pandemiaplan/IncuNest/Hardware/Electronics/FullLEDStrip/in3ator_LEDStrip2.html

Reporting Options

# File in Newer Format

Date | : | 14/08/2024
Time | : | 11:28:09
Project name | : | C:\Users\Administrator\Documents\in3ator_altium\Prototypes\FullLEDStrip2\in3ator_LEDStrip2.PrjPcb
Schematic documents | : | in3ator_LEDStrip2.SchDoc

Version | Warning
22.3.0 | Custom diff pair suffixes are not supported in this version.

These files were generated in a later version of Altium Designer. Be aware that some data may have been added through functionality not available in your current version and will therefore not be available to you.
