pandemiaplan/IncuNest/Hardware/Electronics/Ambient_sensor/PCB_Project/Project Outputs for in3ator_RoomSensor/BOM/Bill of Materials-in3ator_RoomSensor.xlsx

Comment | Designator | Quantity | LCSC_PN
100nF 0402 X7R 50V | C1, C5 | 2 | C77020
1uF 0402 X5R 25V | C7, C42 | 2 | C77009
ESDALC6V1P6 | D1 | 1 | C1976562
STS35-DIS | U1, U2 | 2 | C5439927
SPX3819M5-L-3-3/TR | U7 | 1 | C9055
XKB U262-16XN-4BVC11 | USB1 | 1 | C319148
