pandemiaplan/IncuNest/Hardware/Electronics/Ambient_sensor/PCB_Project/Project Outputs for in3ator_RoomSensor/v1/BOM/Bill of Materials-in3ator_RoomSensor.xlsx

Comment | Designator | Footprint | JLCPCB Part #（optional）
100nF 0402 X7R 50V | C5 | 1 | C77020
1uF 0402 X5R 25V | C7, C42 | 2 | C77009
ESDA5V3SC5 | D6 | 1 | C2827708
Sensirion SHTC3 | U5 | 1 | C194656
SPX3819M5-L-3-3/TR | U7 | 1 | C9055
XKB U262-16XN-4BVC11 | USB1 | 1 | C319148
