pandemiaplan/IncuNest/Hardware/Electronics/Motherboard/Project Outputs for in3ator/V15.1/JLCPCB/8.E/BOM/Bill of Materials-in3ator(Main).xlsx

Comment | Designator | Quantity | LCSC_PN
CUI CMT-1285C-035 | BUZ1 | 1 | C252915
100nF 0603 X7R 100V | C1, C5, C7, C8, C11, C18, C19, C20, C21, C22, C23, C24, C26, C29, C31 | 15 | C14663
10uF 0603 X5R 25V | C2, C6, C15, C16, C27, C28, C30, C32 | 8 | C479655
1nF 0603 NP0 50V 1% | C3, C34 | 2 | C309468
1uF 0603 X5R 16V | C4, C17, C25, C36 | 4 | C106215
18pF 0603 NPO 5% 50V | C12 | 1 | C107040
330uF ±20% 6V3 6.3mm 7.7mm | C14 | 1 | C88664
220uF 30V 8x10mm 5000hrs | C35 | 1 | C134820
1.5nF 0603 NP0 50V 1% | C37 | 1 | C309468
SMBJ15CA | D1 | 1 | C499834
ESDA6V1-5SC6 | D2, D3, D4, D5, D6, D7 | 6 | C6650
SS14_C83852 | D8 | 1 | C83852
BLM18HG601SN1D | FB1 | 1 | C85830
Degson 2EDGK-5.08-02P-14-00AH | J1, J4 | 2 | C8445
JST B2B-XH-A | J2 | 1 | C158012
TE Connectivity 1734366-3 | J6, J13 | 2 | C32896
B2B-PH-K-S(LF)(SN) | J7 | 1 | C131337
WJ15EDGVC-3.81-2P | J8 | 1 | C8396
KF2EDGVC-5.08-4P | J9 | 1 | C581330
220uH | L1 | 1 | C339959
180uH | L2 | 1 | C329730
150060GS55040 | LED1 | 1 | C84266
BC817-16 | Q1, Q7 | 2 | C126908
Infineon IRLB8314PBF | Q2 | 1 | C492741
IRLML6244TRPBF | Q3, Q4, Q5, Q10, Q11 | 5 | C143946
IPD90P03P404ATMA1 | Q6 | 1 | C148439
NTR1P02LT1G | Q8 | 1 | C2593
FQD2N60CTM | Q9 | 1 | C5386
0.002R 1206 0.5W 1% | R1 | 1 | C154631
10K 0603 0.1W 1% | R2, R11, R14, R19, R21, R23, R25, R27, R28, R29, R30, R37, R38, R39, R42, R45, R50, R51, R52, R55, R59, R60, R62, R67 | 24 | C319939
1K 0603 0.1W 1% | R4, R6, R10, R12, R13, R16, R17, R18, R20, R24, R31, R43, R44, R46, R47, R49, R57 | 17 | C21190
0.1R 0603 0.1W 1% | R5, R26 | 2 | C713431
0R 0603 0.1W 1% | R15, R32, R33, R34, R35, R36, R48, R53, R58, R72 | 10 | C21189
0.02R 1206 0.5W 1% | R22 | 1 | C127690
5k6 0603 0.1W 1% | R56 | 1 | C114627
1R 0603 0.1W 1% | R64, R68, R69 | 3 | C22936
300R 0603 0.1W 1% | R65 | 1 | C114617
180R 0603 0.1W 1% | R66 | 1 | C22828
820R 0603 0.1W 1% | R70 | 1 | C114638
Bourns PEC11R-4215F-S0024 | SW1 | 1 | C470742
Espressif Systems ESP32-WROOM-32D | U1 | 1 | C701343
Simcom SIM800C | U2 | 1 | C69119
Microchip PAC1933T-I/JQ | U4 | 1 | C623959
Texas Instruments INA180A3IDBVR | U5, U12, U15 | 3 | C122882
STMicroelectronics L78M05CDT-TR | U6 | 1 | C173987
Sensirion SHTC3 | U7 | 1 | C194656
LD1117S33CTR | U9, U10 | 2 | C35879
Micrel MIC29302WU | U11 | 1 | C11149
SPX3819M5-L-3-3/TR | U13 | 1 | C9055
NE555DR | U14 | 1 | C596355
MC34063ADR2G | U16 | 1 | C32078
XKB U262-16XN-4BVC11 | USB1, USB2 | 2 | C319148
