pandemiaplan/IncuNest/Hardware/Electronics/Motherboard/Project Outputs for in3ator/V15.1/JLCPCB/9.B/BOM/Bill of Materials-in3ator(Main).xlsx

Comment | Designator | Footprint | JLCPCB Part #
CUI CMT-1285C-035 | BUZ1 | 1 | C252915
100nF 0603 X7R 100V | C1, C5, C5_1, C6, C8, C11, C14, C18, C19, C20, C21, C21_1, C30, C34, C38, C41 | 16 | C14663
10uF 0603 X5R 25V | C2, C2_1, C23, C24, C25, C26, C28, C29, C31, C32, C35, C36, C37, C39, C40 | 15 | C479655
1uF 0603 X5R 16V | C3, C3_1, C4, C7, C7_1, C17, C22, C22_1 | 8 | C106215
18pF 0603 NPO 5% 50V | C12 | 1 | C107040
SMBJ15CA | D1 | 1 | C499834
ESDA6V1-5SC6 | D2 | 1 | C6650
ESDA5V3SC5 | D3, D3_1, D4, D5, D6, D6_1, D7 | 7 | C111204
BAT54S-7-F | D8, D9, D9_1 | 3 | C83574
Degson 2EDGK-5.08-02P-14-00AH | J1, J4 | 2 | C8445
JST B2B-XH-A | J2 | 1 | C158012
TE Connectivity 1734366-3 | J6, J13 | 2 | C32896
B2B-PH-K-S(LF)(SN) | J7, J7_1 | 2 | C131337
WJ15EDGVC-3.81-2P | J8 | 1 | C8396
KF2EDGVC-5.08-4P | J9 | 1 | C581330
HTSW-102-07-G-D | J10, J10_1, J11, J11_1 | 4 | C402780
1217AS-H-3R3N=P3 | L2, L3 | 2 | C160949
150060GS55040 | LED1, LED1_1 | 2 | C84266
BC817-16 | Q1, Q7, Q9 | 3 | C126908
IRLR7843TRPBF | Q2 | 1 | C21988
IRLML6244TRPBF | Q3, Q4, Q11, Q11_1 | 4 | C143946
IPD90P03P404ATMA1 | Q5, Q6 | 2 | C148439
0.002R 1206 0.5W 1% | R1 | 1 | C601094
10K 0603 0.1W 1% | R2, R11, R14, R19, R21, R23, R25, R26, R26_1, R27, R28, R29, R30, R37, R38, R39, R42, R46, R51, R52, R77 | 21 | C319939
1K 0603 0.1W 1% | R4, R6, R10, R12, R13, R16, R17, R18, R20, R31, R43, R44, R47, R47_1, R48, R48_1, R49, R54, R54_1, R64, R64_1 | 21 | C21190
0.1R 0603 0.1W 1% | R5 | 1 | C713431
0R 0603 0.1W 1% | R15, R32, R33, R34, R35, R36, R53, R60, R60_1, R66, R66_1 | 11 | C21189
0.02R 1206 0.5W 1% | R22, R24, R24_1 | 3 | C127690
73K2 0603 0.1W 1% | R45 | 1 | C14890
56K2 0603 0.1W 1% | R50 | 1 | C14890
Bourns PEC11R-4215F-S0024 | SW1 | 1 | C470742
Espressif Systems ESP32-WROOM-32D | U1 | 1 | C701343
Simcom SIM800C | U2 | 1 | C69119
SIM-S-IO3-MFF2-2 | U3 | 1 | C5122390
INA3221AIRGVR | U4 | 1 | C181255
Sensirion SHTC3 | U5, U5_1 | 2 | C194656
TPS563231DRLR | U6, U11 | 2 | C779412
SPX3819M5-L-3-3/TR | U7, U7_1, U12, U12_1 | 4 | C9055
LD1117S33CTR | U10 | 1 | C35879
STM32G030F6P6TR | U13, U13_1 | 2 | C529330
Texas Instruments INA180A3IDBVR | U14, U14_1 | 2 | C122882
XKB U262-16XN-4BVC11 | USB1, USB1_1, USB2, USB2_1 | 4 | C319148
