pandemiaplan/IncuNest/Hardware/Electronics/Motherboard/Project Outputs for in3ator/V15.1/JLCPCB/Humidifier/BOM/Bill of Materials-in3ator(Main).xlsx

Comment | Designator | Footprint | JLCPCB Part #（optional）
CUI CMT-1285C-035 | BUZ1 | 1 | C252915
100nF 0402 X7R 50V | C1, C5, C6, C8, C11, C14, C15, C18, C19, C20, C21, C30, C34, C38, C41, C44, C48, C50 | 18 | C77020
10uF 0402 X5R 10V | C2, C23, C24, C25, C26, C28, C29, C35, C36, C37, C45, C46, C47, C49 | 14 | C77000
1uF 0402 X5R 25V | C3, C4, C7, C17, C22, C27, C42 | 7 | C77009
18pF 0402 X5R 50V | C12, C43 | 2 | C33149
180F 3V8 5mm radial | C16 | 1
10uF 0603 X5R 25V | C31, C32, C39, C40 | 4 | C2230375
SMBJ15CA | D1 | 1 | C78410
ESDA6V1-5SC6 | D2 | 1 | C6650
ESDA5V3SC5 | D3, D6 | 2 | C111204
ESD9B3.3ST5G | D4, D5, D7, D10, D11, D12, D13, D14, D15, D16, D17, D18, D19, D20, D21, D22, D23, D24, D25, D26, D30 | 21 | C96512
MMSZ5231BT1G | D8 | 1 | C66198
BAT54S-7-F | D9 | 1 | C83574
CUS10S30,H3F | D27 | 1 | C146335
Degson 2EDGK-5.08-02P-14-00AH | J1, J4 | 2 | C8445
JST B2B-XH-A | J2 | 1 | C158012
TE Connectivity 1734366-3 | J6, J13 | 2 | C32896
B2B-PH-K-S(LF)(SN) | J7 | 1 | C131337
WJ15EDGVC-3.81-2P | J8 | 1 | C8396
KF2EDGVC-5.08-4P | J9 | 1 | C581330
HTSW-102-07-G-D | J10, J11 | 2 | C402780
B3B-XH-A(LF)(SN) | J12 | 1 | C144394
1217AS-H-3R3N=P3 | L2, L3, L4 | 3 | C514864
150060GS55040 | LED1 | 1 | C84266
BC817-16 | Q1 | 1 | C126908
IRLR7843TRPBF | Q2 | 1 | C21988
IRLML6244TRPBF | Q3, Q4, Q7, Q9, Q11 | 5 | C143946
IPD90P03P404ATMA1 | Q5, Q6 | 2 | C148439
IRLML6402TRPBF | Q8 | 1 | C2593
0.002R 1206 0.5W 1% | R1, R52 | 2 | C601094
10k 0402 0.1% | R2, R3, R7, R8, R9, R11, R14, R19, R21, R23, R25, R26, R27, R28, R29, R30, R31, R37, R38, R39, R40, R41, R46, R57 | 24 | C190095
1k 0402 1% | R4, R6, R10, R12, R13, R16, R17, R18, R20, R43, R44, R47, R48, R49, R54, R64 | 16 | C106235
0.1R 1206 0.5W 1% | R5, R51 | 2 | C601090
0R 0402 1% | R15, R32, R33, R34, R35, R42, R53, R63 | 8 | C60485
0.082R 1206 0.5W 1% | R22 | 1 | C705560
0.02R 1206 0.5W 1% | R24 | 1 | C127690
27R 1206 0.75W 1% | R36 | 1 | C2081644
73k2 0402 1% | R45 | 1 | C185398
51k 0402 0.1% | R50 | 1 | C149896
Bourns PEC11R-4215F-S0024 | SW1 | 1 | C470742
XKB7070-Z | SW2 | 1 | C318863
Espressif Systems ESP32-WROOM-32D | U1 | 1 | C701343
Simcom SIM800C | U2 | 1 | C69119
eSIM MFF2 | U3 | 1 | C5122390
INA3221AIRGVR | U4, U9 | 2 | C181255
Sensirion SHTC3 | U5 | 1 | C194656
TPS563231DRLR | U6, U11 | 2 | C779412
SPX3819M5-L-3-3/TR | U7, U12 | 2 | C9055
2.8 TFT ST7789V | U8 | 1 | C2939938
TPS63001DRCR | U10 | 1
STM32G030F6P6TR | U13 | 1 | C529330
Texas Instruments INA180A3IDBVR | U14 | 1 | C122882
SHT40-AD1B-R2 | U15 | 1
XKB U262-16XN-4BVC11 | USB1, USB2 | 2 | C319148
