pandemiaplan/IncuNest/Hardware/Electronics/FullLEDStrip/Project Outputs for in3ator_LEDStrip2/BOM/Bill of Materials-in3ator_LEDStrip2.xlsx

Comment | Designator | Footprint | JLCPCB Part #（optional）
XL-3014UBC-02 | D1, D2, D3, D4, D5, D6, D7, D8, D9, D10, D11, D12, D13, D14, D15, D16, D17, D18, D19, D20, D21, D22, D23, D24, D25, D26, D27, D28, D29, D30, D31, D32, D33, D34, D35, D36, D37, D38, D39, D40, D41, D42, D43, D44, D45, D46, D47, D48, D49, D50, D51, D52, D53, D54, D55, D56, D57, D58, D59, D60, D61, D62, D63, D64, D65, D66, D67, D68, D69, D70, D71, D72, D73, D74, D75 | 75 | C2843789
39R 1206 0.5W 1% | R1, R2, R3, R4, R5, R6, R7, R8, R9, R10, R11, R12, R13, R14, R15, R16, R17, R18, R19, R20, R21, R22, R23, R24, R25 | 25 | C137295
