pandemiaplan/IncuNest/(list of files, cad)

Other CAD files:
Hardware/Electronics/Motherboard/Step/IncuNest.step
Hardware/Mechanical/IN3_structure_v12 v87.step
