pandemiaplan/IncuNest/Firmware/motherBoard/ESP32S3_OTA_partition_8MB.csv

# Name | Type | SubType | Offset | Size | Flags
nvs | data | nvs | 0x9000 | 0x5000
otadata | data | ota | 0xE000 | 0x2000
app0 | app | ota_0 | 0x10000 | 0x2A0000
app1 | app | ota_1 | 0x2B0000 | 0x2A0000
spiffs | data | spiffs | 0x550000 | 0x200000
