pandemiaplan/IncuNest/Firmware/motherBoard/ESP32_OTA_partition_4MB.csv

# Name | Type | SubType | Offset | Size | Flags
nvs | data | nvs | 0x9000 | 0x4000
otadata | data | ota | 0xd000 | 0x2000
app0 | app | ota_0 | 0x10000 | 0x1F0000
app1 | app | ota_1 | 0x200000 | 0x1F0000
spiffs | data | spiffs | 0x3F0000 | 0x10000
