pandemiaplan/IncuNest/(list of files, drawings)

Other design files:
Hardware/Electronics/Ambient_sensor/PCB/RoomSensor.PcbDoc
Hardware/Electronics/Ambient_sensor/PCB_Project/in3ator_RoomSensor.PrjPcb
Hardware/Electronics/Ambient_sensor/Schematic/Camera.SchDoc
Hardware/Electronics/Ambient_sensor/Schematic/Main.SchDoc
Hardware/Electronics/Ambient_sensor/Schematic/Power_Input.SchDoc
Hardware/Electronics/Ambient_sensor/Schematic/Sensors.SchDoc
Hardware/Electronics/Ambient_sensor/Schematic/uC.SchDoc
Hardware/Electronics/FullLEDStrip/in3ator_LEDStrip2.PcbDoc
Hardware/Electronics/FullLEDStrip/in3ator_LEDStrip2.PcbLib
Hardware/Electronics/FullLEDStrip/in3ator_LEDStrip2.PrjPcb
Hardware/Electronics/FullLEDStrip/in3ator_LEDStrip2.SchDoc
Hardware/Electronics/FullLEDStrip/in3ator_LEDStrip2.SchLib
Hardware/Electronics/Motherboard/IncuNest.PrjPcb
Hardware/Electronics/Motherboard/Project Outputs for in3ator/V15.1/Sources/in3ator.PrjPcb
Hardware/Electronics/Motherboard/Project Outputs for in3ator/V15.1/Sources/Schematic/Actuators.SchDoc
Hardware/Electronics/Motherboard/Project Outputs for in3ator/V15.1/Sources/Schematic/AFE.SchDoc
Hardware/Electronics/Motherboard/Project Outputs for in3ator/V15.1/Sources/Schematic/Battery.SchDoc
Hardware/Electronics/Motherboard/Project Outputs for in3ator/V15.1/Sources/Schematic/Buzzer.SchDoc
Hardware/Electronics/Motherboard/Project Outputs for in3ator/V15.1/Sources/Schematic/GSM.SchDoc
Hardware/Electronics/Motherboard/Project Outputs for in3ator/V15.1/Sources/Schematic/in3ator.SchDoc
Hardware/Electronics/Motherboard/Project Outputs for in3ator/V15.1/Sources/Schematic/Power_Input.SchDoc
Hardware/Electronics/Motherboard/Project Outputs for in3ator/V15.1/Sources/Schematic/Power_management.SchDoc
Hardware/Electronics/Motherboard/Project Outputs for in3ator/V15.1/Sources/Schematic/Sensors.SchDoc
Hardware/Electronics/Motherboard/Project Outputs for in3ator/V15.1/Sources/Schematic/uC.SchDoc
Hardware/Electronics/Motherboard/Schematic/Actuators.SchDoc
Hardware/Electronics/Motherboard/Schematic/AFE.SchDoc
Hardware/Electronics/Motherboard/Schematic/Battery.SchDoc
Hardware/Electronics/Motherboard/Schematic/Buzzer.SchDoc
Hardware/Electronics/Motherboard/Schematic/Display.SchDoc
Hardware/Electronics/Motherboard/Schematic/GSM.SchDoc
Hardware/Electronics/Motherboard/Schematic/Main.SchDoc
Hardware/Electronics/Motherboard/Schematic/Power_Input.SchDoc
Hardware/Electronics/Motherboard/Schematic/Power_management.SchDoc
Hardware/Electronics/Motherboard/Schematic/Sensors.SchDoc
Hardware/Electronics/Motherboard/Schematic/uC.SchDoc
Hardware/Electronics/old/Humidifier/PCB/Humidifier.PcbDoc
Hardware/Electronics/old/Humidifier/PCB_Project/in3ator_Humidifier.PrjPcb
Hardware/Electronics/old/Humidifier/Schematic/Humidifier.SchDoc
