pandemiaplan/IncuNest/Firmware/motherBoard/src/sensors.cpp

/*
  MIT License

  Copyright (c) 2022 Medical Open World, Pablo Sánchez Bergasa

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
*/
#include <Arduino.h>

#include "main.h"

extern TwoWire *wire;
extern MAM_in3ator_Humidifier in3_hum;
extern TFT_eSPI tft;
extern SHTC3 mySHTC3; // Declare an instance of the SHTC3 class
extern SensirionI2cSts3x mySTS35[STS3X_NUM];
extern Adafruit_SHT4x sht4;
extern RotaryEncoder encoder;
extern Beastdevices_INA3221 mainDigitalCurrentSensor;
extern Beastdevices_INA3221 secundaryDigitalCurrentSensor;

extern bool WIFI_EN;
extern long lastDebugUpdate;
extern long loopCounts;
extern int page;
extern double errorTemperature[SENSOR_TEMP_QTY], temperatureCalibrationPoint;
extern double ReferenceTemperatureRange, ReferenceTemperatureLow;
extern double provisionalReferenceTemperatureLow;
extern double fineTuneSkinTemperature, fineTuneAirTemperature;
extern double RawTemperatureLow[SENSOR_TEMP_QTY],
    RawTemperatureRange[SENSOR_TEMP_QTY];
extern double provisionalRawTemperatureLow[SENSOR_TEMP_QTY];
extern int temperature_array_pos; // temperature sensor number turn to measure
extern float diffSkinTemperature,
    diffAirTemperature; // difference between measured temperature and user
                        // input real temperature
extern bool humidifierState, humidifierStateChange;
extern int previousHumidity; // previous sampled humidity
extern float diffHumidity;   // difference between measured humidity and user
                             // input real humidity

extern byte autoCalibrationProcess;

// Sensor check rate (in ms). Both sensors are checked in same interrupt and
// they have different check rates
extern byte encoderRate;
extern byte encoderCount;

extern volatile long lastEncPulse;
extern volatile bool statusEncSwitch;

// WIFI
extern bool WIFI_connection_status;

extern bool roomSensorPresent[ROOM_SENSOR_POSIBILITIES];
extern bool ambientSensorPresent;
extern bool digitalCurrentSensorPresent[2];

// room variables;
extern boolean A_set;
extern boolean B_set;
extern int encoderpinA;                 // pin  encoder A
extern int encoderpinB;                 // pin  encoder B
extern bool encPulsed, encPulsedBefore; // encoder switch status
extern bool updateUIData;
extern volatile int EncMove;     // moved encoder
extern volatile int lastEncMove; // moved last encoder
extern volatile int
    EncMoveOrientation;            // set to -1 to increase values clockwise
extern int last_encoder_move;      // moved encoder
extern long encoder_debounce_time; // in milliseconds, debounce time in encoder
                                   // to filter signal bounces
extern long last_encPulsed;        // last time encoder was pulsed

// Text Graphic position variables
extern int humidityX;
extern int humidityY;
extern int temperatureX;
extern int temperatureY;
extern int ypos;
extern bool print_text;
extern int initialSensorPosition;
extern bool pos_text[8];

extern bool enableSet;
extern float temperaturePercentage, temperatureAtStart;
extern float humidityPercentage, humidityAtStart;
extern int barWidth, barHeight, tempBarPosX, tempBarPosY, humBarPosX,
    humBarPosY;
extern int screenTextColor, screenTextBackgroundColour;

// User Interface display variables
extern bool autoLock; // setting that enables backlight switch OFF after a
                      // given time of no user actions
extern long
    lastbacklightHandler; // last time there was a encoder movement or pulse

extern bool selected;
extern char cstring[128];
extern char *textToWrite;
extern char *words[12];
extern char *helpMessage;
extern byte bar_pos;
extern byte menu_rows;
extern byte length;
extern long lastGraphicSensorsUpdate;
extern long lastSensorsUpdate;
extern bool enableSetProcess;
extern long blinking;
extern bool state_blink;
extern bool blinkSetMessageState;
extern long lastBlinkSetMessage;

extern long lastSuccesfullSensorUpdate[SENSOR_TEMP_QTY];
extern QueueHandle_t sharedSensorQueue;

extern double HeaterPIDOutput;
extern double skinControlPIDInput;
extern double airControlPIDInput;
extern double humidityControlPIDOutput;
extern int humidifierTimeCycle;
extern unsigned long windowStartTime;

extern double Kp[numPID], Ki[numPID], Kd[numPID];
extern PID airControlPID;
extern PID skinControlPID;
extern PID humidityControlPID;

// Sampling frequency
const double FILTER_SAMPLE_FREQUENCY = 1000; // Hz
// Cut-off frequency (-3 dB)
const double FILTER_CUTOFF_FREQUENCY = 10; // Hz
// Normalized cut-off frequency
const double FILTER_NORMALIZED_CUT_OFF_FREQUENCY =
    (2 * FILTER_CUTOFF_FREQUENCY / FILTER_SAMPLE_FREQUENCY);

// Sample timer for filter
Timer<micros> timer = std::round(1e6 / FILTER_SAMPLE_FREQUENCY);
// Sixth-order Butterworth filter
auto filter_0 = butter<6>(FILTER_NORMALIZED_CUT_OFF_FREQUENCY);
auto filter_1 = butter<6>(FILTER_NORMALIZED_CUT_OFF_FREQUENCY);
auto filter_2 = butter<6>(FILTER_NORMALIZED_CUT_OFF_FREQUENCY);

extern in3ator_parameters in3;

long lastCurrentMeasurement, lastVoltageMeasurement;
long lastEncoderUpdate;

void currentMonitor() {
  if (millis() - lastCurrentMeasurement > CURRENT_UPDATE_PERIOD_MS) {
    if (digitalCurrentSensorPresent[MAIN]) {
      in3.system_current = measureMeanConsumption(MAIN, SYSTEM_SHUNT_CHANNEL);
      in3.fan_current = measureMeanConsumption(MAIN, FAN_SHUNT_CHANNEL);
      in3.phototherapy_current =
          measureMeanConsumption(MAIN, PHOTOTHERAPY_SHUNT_CHANNEL);
    }
    if (digitalCurrentSensorPresent[SECUNDARY]) {
      in3.heater_current =
          measureMeanConsumption(SECUNDARY, HEATER_SHUNT_CHANNEL);
      in3.USB_current = measureMeanConsumption(SECUNDARY, USB_SHUNT_CHANNEL);
      in3.BATTERY_current =
          measureMeanConsumption(SECUNDARY, BATTERY_SHUNT_CHANNEL);
    }
    lastCurrentMeasurement = millis();
  }
}

void voltageMonitor() {
  if (millis() - lastVoltageMeasurement > VOLTAGE_UPDATE_PERIOD_MS) {
    if (digitalCurrentSensorPresent[MAIN]) {
      in3.system_voltage = measureMeanVoltage(MAIN, SYSTEM_SHUNT_CHANNEL);
    }
    if (digitalCurrentSensorPresent[SECUNDARY]) {
      in3.USB_voltage = measureMeanVoltage(SECUNDARY, USB_SHUNT_CHANNEL);
      in3.BATTERY_voltage =
          measureMeanVoltage(SECUNDARY, BATTERY_SHUNT_CHANNEL);
    }
    lastVoltageMeasurement = millis();
  }
}

double measureMeanConsumption(bool sensor, int shunt) {
#if (HW_NUM >= 6 && HW_NUM <= 8)
  for (int i = 0; i < CURRENT_MEASURES_AMOUNT; i++) {
    in3.system_current = filter_2(analogReadMilliVolts(SYSTEM_CURRENT_SENSOR) *
                                  ANALOG_TO_AMP_FACTOR);
  }
  return (in3.system_current);
#else
  if (digitalCurrentSensorPresent[sensor]) {
    if (sensor == SECUNDARY) {
      return (secundaryDigitalCurrentSensor.getCurrent(
          ina3221_ch_t(shunt))); // Amperes
    }
    return (
        mainDigitalCurrentSensor.getCurrent(ina3221_ch_t(shunt))); // Amperes
  }
#endif
  return (false);
}

float measureMeanVoltage(bool sensor, int shunt) {
  if (digitalCurrentSensorPresent[sensor]) {
    if (sensor) {
      return (secundaryDigitalCurrentSensor.getVoltage(
          ina3221_ch_t(shunt))); // Volts
    }
    return (mainDigitalCurrentSensor.getVoltage(ina3221_ch_t(shunt))); // Volts
  }
  return (false);
}

float adcToCelsius(float adcReading) {
  // Valores fijos del circuito
  float rAux = 10000.0;
  float vcc = 3.3;
  float beta = 3950.0;
  float temp0 = 298.0;
  float r0 = 10000.0;
  // float adcReadingCorrection = 215;
  // Bloque de cálculo
  // Variables used in calculus
  float vm = 0.0;
  float rntc = 0.0;
  if (adcReading) {
    if (ADC_READ_FUNCTION == MILLIVOTSREAD_ADC) {
      rntc = rAux / ((vcc / (adcReading / 1000)) -
                     1); // Calcular la resistencia de la NTC
    } else if (ADC_READ_FUNCTION == ANALOGREAD_ADC) {
      vm = (vcc) *
           ((adcReading) / maxADCvalue); // Calcular tensión en la entrada
      rntc = rAux / ((vcc / vm) - 1);
    }
  } else {
    return false;
  }
  return (beta / (log(rntc / r0) + (beta / temp0)) -
          273.15); // Calcular la temperatura en Celsius
}

void fanSpeedHandler() {
  double fanEncoderPeriodFiltered;
  if (in3.fanEncoderUpdate) {
    in3.fanEncoderUpdate = false;
    lastEncoderUpdate = millis();
    fanEncoderPeriodFiltered =
        filter_0(in3.fanEncoderPeriod[1] - in3.fanEncoderPeriod[0]);
    if (fanEncoderPeriodFiltered) {
      in3.fan_rpm = FAN_RPM_CONVERSION / fanEncoderPeriodFiltered;
    }
  } else if (millis() - lastEncoderUpdate > FAN_UPDATE_TIME_MIN) {
    in3.fan_rpm = false;
  }
}

bool measureNTCTemperature() {
  int NTCmeasurement;
  if (ADC_READ_FUNCTION == MILLIVOTSREAD_ADC) {
    NTCmeasurement = analogReadMilliVolts(BABY_NTC_PIN);
  } else if (ADC_READ_FUNCTION == ANALOGREAD_ADC) {
    NTCmeasurement = analogRead(BABY_NTC_PIN);
  }
  if (NTCmeasurement > ADC_TO_DISCARD_MIN &&
      NTCmeasurement < ADC_TO_DISCARD_MAX) {
    lastSuccesfullSensorUpdate[SKIN_SENSOR] = millis();
    //        xQueueSend(sharedSensorQueue,
    //        &lastSuccesfullSensorUpdate[SKIN_SENSOR], portMAX_DELAY);
    in3.temperature[SKIN_SENSOR] = filter_1(adcToCelsius(NTCmeasurement));
    errorTemperature[SKIN_SENSOR] = in3.temperature[SKIN_SENSOR];
    if (RawTemperatureRange[SKIN_SENSOR]) {
      in3.temperature[SKIN_SENSOR] =
          (((in3.temperature[SKIN_SENSOR] - RawTemperatureLow[SKIN_SENSOR]) *
            ReferenceTemperatureRange) /
           RawTemperatureRange[SKIN_SENSOR]) +
          ReferenceTemperatureLow;
    }
    in3.temperature[SKIN_SENSOR] += fineTuneSkinTemperature;
    errorTemperature[SKIN_SENSOR] -= in3.temperature[SKIN_SENSOR];
    if (in3.temperature < 0) {
      in3.temperature[SKIN_SENSOR] = 0;
    }
    return true;
  } else {
    // logAlarm("[ALARM] -> NTC read is: " + String(NTCmeasurement));
    return false;
  }
  return false;
}

bool updateRoomSensor() {
  static char errorMessage[64];
  SHTC3_Status_TypeDef shtc3_sensor_status;

  // Acumuladores/flags para STS3X
  bool sts_main_ok = false;
  bool sts_red_ok = false;
  float sts_main_T = 0.0f;
  float sts_red_T = 0.0f;
  bool saw_sts_red =
      false; // Sabremos si pasamos por el REDUNDANT en este ciclo

  for (int i = 0; i < ROOM_SENSOR_POSIBILITIES; i++) {
    if (!roomSensorPresent[i])
      continue;

    switch (i) {
    case ROOM_SENSOR_STS3X_MAIN: {
      float aTemperature = 0.0f;
      uint16_t err =
          mySTS35[i].measureSingleShot(REPEATABILITY_HIGH, false, aTemperature);
      if (err != NO_ERROR) {
        errorToString(err, errorMessage, sizeof(errorMessage));
        logI(String("Error in measureSingleShot() STS3X_MAIN: ") +
             String(errorMessage));
        break;
      }
      if (aTemperature > DIG_TEMP_TO_DISCARD_MIN &&
          aTemperature < DIG_TEMP_TO_DISCARD_MAX) {
        sts_main_ok = true;
        sts_main_T = aTemperature;
        logI(String("STS35[MAIN] OK: ") + String(aTemperature, 2) + " °C");
      } else {
        logI(String("STS35[MAIN] out of range: ") + String(aTemperature, 2) +
             " °C");
      }
      break;
    }
    case ROOM_SENSOR_STS3X_REDUNDANT: {
      float aTemperature = 0.0f;
      uint16_t err =
          mySTS35[i].measureSingleShot(REPEATABILITY_HIGH, false, aTemperature);
      saw_sts_red = true;
      if (err != NO_ERROR) {
        errorToString(err, errorMessage, sizeof(errorMessage));
        logI(String("Error in measureSingleShot() STS3X_REDUNDANT: ") +
             String(errorMessage));
        break;
      }
      if (aTemperature > DIG_TEMP_TO_DISCARD_MIN &&
          aTemperature < DIG_TEMP_TO_DISCARD_MAX) {
        sts_red_ok = true;
        sts_red_T = aTemperature;
        logI(String("STS35[RED] OK: ") + String(aTemperature, 2) + " °C");
      } else {
        logI(String("STS35[RED] out of range: ") + String(aTemperature, 2) +
             " °C");
      }
      break;
    }

    case ROOM_SENSOR_SHTC3: {
      shtc3_sensor_status = mySHTC3.update();
      if (!shtc3_sensor_status) {
        float sensedTemperature = mySHTC3.toDegC();
        if (sensedTemperature > DIG_TEMP_TO_DISCARD_MIN &&
            sensedTemperature < DIG_TEMP_TO_DISCARD_MAX) {
          lastSuccesfullSensorUpdate[ROOM_DIGITAL_TEMP_SENSOR] = millis();
          in3.temperature[ROOM_DIGITAL_TEMP_SENSOR] = sensedTemperature;
          in3.humidity[ROOM_DIGITAL_HUM_SENSOR] = mySHTC3.toPercent();
          logI(String("SHTC3 OK: ") + String(sensedTemperature, 2) + " °C, " +
               String(in3.humidity[ROOM_DIGITAL_HUM_SENSOR], 2) + " %RH");
        }
      }
      break;
    }
    default:
      break;
    }
  }

  // Confirmamos éxito con STS3X solo cuando:
  // - ya pasamos por el REDUNDANT
  // - y ambas lecturas son válidas
  if (saw_sts_red && sts_main_ok && sts_red_ok) {
    float avgT = (sts_main_T + sts_red_T) * 0.5f;
    lastSuccesfullSensorUpdate[ROOM_DIGITAL_TEMP_SENSOR] = millis();
    in3.temperature[ROOM_DIGITAL_TEMP_SENSOR] = avgT;
    return true;
  }

  if (!shtc3_sensor_status) {
    return true;
  }
  initRoomSensor();
  return false;
}

bool updateAmbientSensor() {
  if (ambientSensorPresent) {
    sensors_event_t humidity, temp;
    sht4.getEvent(&humidity,
                  &temp); // populate temp and humidity objects with fresh data
    in3.temperature[AMBIENT_DIGITAL_TEMP_SENSOR] = temp.temperature;
    in3.humidity[AMBIENT_DIGITAL_HUM_SENSOR] = humidity.relative_humidity;
    return true;
  } else {
    initAmbientSensor();
  }
  return false;
}
