pandemiaplan/IncuNest/Firmware/motherBoard/src/drawGraphicInterphace.cpp

/*
  MIT License

  Copyright (c) 2022 Medical Open World, Pablo Sánchez Bergasa

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
*/
#include <Arduino.h>

#include "main.h"

extern TwoWire *wire;
extern MAM_in3ator_Humidifier in3_hum;
extern TFT_eSPI tft;
extern RotaryEncoder encoder;

extern bool WIFI_EN;
extern long lastDebugUpdate;
extern long loopCounts;
extern int page;

extern double errorTemperature[SENSOR_TEMP_QTY], temperatureCalibrationPoint;
extern double ReferenceTemperatureRange, ReferenceTemperatureLow;
extern double provisionalReferenceTemperatureLow;
extern double fineTuneSkinTemperature;
extern double RawTemperatureLow[SENSOR_TEMP_QTY],
    RawTemperatureRange[SENSOR_TEMP_QTY];
extern double provisionalRawTemperatureLow[SENSOR_TEMP_QTY];
extern int temperature_array_pos; // temperature sensor number turn to measure
extern float diffSkinTemperature,
    diffAirTemperature; // difference between measured temperature and user
                        // input real temperature
extern bool humidifierState, humidifierStateChange;
extern int previousHumidity; // previous sampled humidity
extern float diffHumidity;   // difference between measured humidity and user
                             // input real humidity

extern byte autoCalibrationProcess;

// Sensor check rate (in ms). Both sensors are checked in same interrupt and
// they have different check rates
extern byte encoderRate;
extern byte encoderCount;

extern volatile long lastEncPulse;
extern volatile bool statusEncSwitch;

// WIFI
extern bool WIFI_connection_status;

// room variables

extern boolean A_set;
extern boolean B_set;
extern int encoderpinA;                 // pin  encoder A
extern int encoderpinB;                 // pin  encoder B
extern bool encPulsed, encPulsedBefore; // encoder switch status
extern bool updateUIData;
extern volatile int EncMove;     // moved encoder
extern volatile int lastEncMove; // moved last encoder
extern volatile int
    EncMoveOrientation;            // set to -1 to increase values clockwise
extern int last_encoder_move;      // moved encoder
extern long encoder_debounce_time; // in milliseconds, debounce time in encoder
                                   // to filter signal bounces
extern long last_encPulsed;        // last time encoder was pulsed

// Text Graphic position variables
extern int humidityX;
extern int humidityY;
extern int temperatureX;
extern int temperatureY;
extern int separatorTopYPos, separatorMidYPos, separatorBotYPos;
extern int ypos;
extern bool print_text;
extern int initialSensorPosition;
extern bool pos_text[8];

extern bool enableSet;
extern float temperaturePercentage, temperatureAtStart;
extern float humidityPercentage, humidityAtStart;
extern int barWidth, barHeight, tempBarPosX, tempBarPosY, humBarPosX,
    humBarPosY;
extern int screenTextColor, screenTextBackgroundColour;

// User Interface display variables
extern bool autoLock; // setting that enables backlight switch OFF after a
                      // given time of no user actions
extern long
    lastbacklightHandler; // last time there was a encoder movement or pulse

extern bool selected;
extern char cstring[128];
extern char *textToWrite;
extern char *words[12];
extern char *helpMessage;
extern byte bar_pos;
extern byte menu_rows;
extern byte length;
extern long lastGraphicSensorsUpdate;
extern long lastSensorsUpdate;
extern bool enableSetProcess;
extern long blinking;
extern bool state_blink;
extern bool blinkSetMessageState;
extern long lastBlinkSetMessage;

extern double HeaterPIDOutput;
extern double skinControlPIDInput;
extern double airControlPIDInput;
extern double humidityControlPIDOutput;
extern int humidifierTimeCycle;
extern unsigned long windowStartTime;

extern int tft_width, tft_height;

extern PID airControlPID;
extern PID skinControlPID;
extern PID humidityControlPID;

extern GPRSstruct GPRS;

extern in3ator_parameters in3;

void setTextColor(int16_t colour) { screenTextColor = colour; }

void setBackgroundColor(int16_t colour) { screenTextBackgroundColour = colour; }

int16_t getBackgroundColor() { return screenTextBackgroundColour; }

void setSensorsGraphicPosition(int UI_page)
{
  switch (UI_page)
  {
  case MAIN_MENU_PAGE:
    humidityX = tft_width - 50;
    humidityY = graphicHeight(HUMIDITY_UI_ROW);
    temperatureX = tft_width - 79;
    temperatureY = graphicHeight(TEMPERATURE_UI_ROW);
    break;
  case ACTUATORS_PROGRESS_PAGE:
    barWidth = tft_width / 4 * 2;
    barHeight = 20;
    tempBarPosX = tft_width / 2;
    tempBarPosY = tft_height / 3 - 11;
    humBarPosX = tempBarPosX;
    humBarPosY = tft_height * 3 / 4 + 15;
    temperatureX = letter_width;
    temperatureY = tempBarPosY - barHeight / 2;
    humidityX = 4 * letter_width;
    humidityY = humBarPosY - barHeight / 2;
    separatorTopYPos = tft_height / 3 + 5;
    separatorMidYPos = tft_height * 2 / 3 - 10;
    break;
  }
}
int16_t drawString(char *string, int16_t poX, int16_t poY, int16_t size)
{
  int16_t sumX = 0;
  int16_t width = 8;
  int16_t gap = -2;

  while (*string)
  {
    tft.drawChar(poX, poY, *string, screenTextColor, screenTextBackgroundColour,
                 size);
    *string++;
    poX += (width + gap) * size; /* Move cursor right       */
  }
  return sumX;
}

void drawHeading(int UI_page, int UI_serialNumber)
{
  tft.fillRect(0, 0, tft_width, TFT_HEIGHT_HEADING, COLOUR_HEADING);
  if (UKRAINE_MODE)
  {
    tft.fillRect(0, TFT_HEIGHT_HEADING / 2, tft_width, TFT_HEIGHT_HEADING / 2,
                 YELLOW);
  }
  if (UI_page != MAIN_MENU_PAGE)
  {
    drawBack();
  }
  setTextColor(COLOUR_MENU);
  drawCentreString((char *)("in3_"),
                   tft_width / 2 - 2 * letter_width - 10, headint_text_height,
                   textFontSize);
  drawCentreNumber(UI_serialNumber, tft_width / 2, headint_text_height);
  drawCentreString(
      convertStringToChar(cstring, String(FWversion) + "/" + HWversion),
      tft_width - 4 * letter_width, headint_text_height, textFontSize);
}

void updateHeadingEvent(byte Event, bool event_status)
{
  uint16_t currentBackgroundColor = getBackgroundColor();
  setBackgroundColor(COLOUR_HEADING);
  if (event_status)
  {
    setTextColor(COLOUR_MENU);
  }
  else
  {
    setTextColor(COLOUR_HEADING);
  }
  switch (Event)
  {
  case EVENT_2G:
    drawCentreString((char *)("2G"), EVENT_2G_UI_POS,
                     headint_text_height, textFontSize);
    break;
  case EVENT_WIFI:
    drawCentreString((char *)("W"), EVENT_WIFI_UI_POS,
                     headint_text_height, textFontSize);
    break;
  case EVENT_SERVER_CONNECTION:
    drawCentreString((char *)("S"),
                     EVENT_SERVER_CONNECTION_UI_POS, headint_text_height,
                     textFontSize);
    break;
  case EVENT_OTA_ONGOING:
    drawCentreString((char *)("O"),
                     EVENT_OTA_ONGOING_UI_POS, headint_text_height,
                     textFontSize);
    break;
  default:
    break;
  }
  setBackgroundColor(currentBackgroundColor);
}

void UI_updateConnectivityEvents()
{
  updateHeadingEvent(EVENT_2G, GPRSIsAttached());
  updateHeadingEvent(EVENT_WIFI, WIFIIsConnected());
  updateHeadingEvent(EVENT_SERVER_CONNECTION,
                     GPRSIsConnectedToServer() || WIFIIsConnectedToServer());
}

void eraseBar(int UI_menu_rows, int bar_pos)
{
  if (UI_menu_rows)
  {
    tft.fillRect(
        0,
        (tft_height - TFT_HEIGHT_HEADING) * (bar_pos - 1) / UI_menu_rows +
            TFT_HEIGHT_HEADING,
        width_select, (tft_height - TFT_HEIGHT_HEADING) / UI_menu_rows,
        COLOUR_BAR);
  }
}

void updateBar(int UI_menu_rows, int bar_pos)
{
  if (UI_menu_rows)
  {
    tft.fillRect(
        0,
        (tft_height - TFT_HEIGHT_HEADING) * (bar_pos - 1) / UI_menu_rows +
            TFT_HEIGHT_HEADING,
        width_select, (tft_height - TFT_HEIGHT_HEADING) / UI_menu_rows,
        COLOUR_SELECTED);
    for (int i = 2; i <= UI_menu_rows; i++)
    {
      tft.fillRect(0,
                   (tft_height - TFT_HEIGHT_HEADING) * (i - 1) / UI_menu_rows +
                       TFT_HEIGHT_HEADING - 1,
                   tft_height, TFT_SEPARATOR_HEIGHT, WHITE); // mejorable
    }
  }
}

int16_t drawNumber(long long_num, int16_t poX, int16_t poY, int16_t size)
{
  char tmp[10];
  if (long_num < 0)
    sprintf(tmp, "%li", long_num);
  else
    sprintf(tmp, "%lu", long_num);
  return drawString(tmp, poX, poY, size);
}

void drawBack()
{
  tft.fillRect(0, 0, width_back, TFT_HEIGHT_HEADING, COLOUR_HEADING);
  tft.drawRect(0, 0, width_back, TFT_HEIGHT_HEADING, BLACK);
  tft.fillTriangle(arrow_height, TFT_HEIGHT_HEADING / 2, width_back / 2,
                   arrow_height, width_back / 2, TFT_HEIGHT_HEADING - arrow_height,
                   COLOUR_ARROW);
  tft.fillRect(width_back / 2, TFT_HEIGHT_HEADING / 2 - arrow_tail,
               width_back / 2 - arrow_height, arrow_tail, COLOUR_ARROW);
  tft.fillRect(width_back / 2, TFT_HEIGHT_HEADING / 2,
               width_back / 2 - arrow_height, arrow_tail, COLOUR_ARROW);
}

void drawRightNumber(int n, int x, int i)
{
  length = true;
  for (long k = 10; k <= n; k *= 10)
  {
    length++;
  }
  drawNumber(n, x - length * 14, i, textFontSize);
}

void drawIntroMessage()
{
  byte numWords = 3;
  switch (in3.language)
  {
  case ENGLISH:
    words[0] = (char *)("Welcome to in3ator");
    words[1] = (char *)("");
    words[2] = (char *)("Saving lives");
    break;
  case SPANISH:
    words[0] = (char *)("Bienvenido a in3");
    words[1] = (char *)("");
    words[2] = (char *)("Salvando vidas");
    break;
  case FRENCH:
    words[0] = (char *)("Bienvenue a in3");
    words[1] = (char *)("");
    words[2] = (char *)("Sauver des vies");
    break;
  case PORTUGUESE:
    words[0] = (char *)("Bem-vindo ao");
    words[1] = (char *)("");
    words[2] = (char *)("Salvando vidas");
    break;
  }
  for (int i = false; i < numWords; i++)
  {
    drawCentreString(words[i], tft_width / 2,
                     tft_height * (1 + i) / (2 + numWords), textFontSize);
  }
}

void drawAlarmMessage(char *alertMessage)
{
  setTextColor(COLOUR_WARNING_TEXT);
  drawCentreString(alertMessage,
                   width_select + (tft_width - width_select) / 2,
                   headint_text_height, textFontSize);
}

void drawHumidityUnits()
{
  drawRightString((char *)("/"), separatorPosition, ypos,
                  textFontSize);
  drawRightString((char *)("%"), unitPosition, ypos,
                  textFontSize);
}

int decimalDigits(long n)
{
  int length = true;
  for (long k = 10; k <= n; k *= 10)
  {
    length++;
  }
  return (length);
}

void drawCentreNumber(int n, int x, int i)
{
  drawNumber(n, x - decimalDigits(n) * 7, i, textFontSize);
}

int hexDigits(long n)
{
  int length = true;
  for (long k = 16; k <= n; k *= 16)
  {
    length++;
  }
  return (length);
}

void drawStop()
{
  switch (in3.language)
  {
  case SPANISH:
    textToWrite = (char *)("Pulsa 2 seg para salir");
    break;
  case ENGLISH:
    textToWrite = (char *)("Press 2 sec to go back");
    break;
  case FRENCH:
    textToWrite = (char *)("Appuyez 2 sec pour finir");
    break;
  case PORTUGUESE:
    textToWrite =
        (char *)("Pressione 2 segundos para sair");
    break;
  }
  drawCentreString(textToWrite, tft_width / 2, tft_height - letter_height,
                   textFontSize);
}

int graphicHeight(int position)
{
  if (menu_rows)
  {
    return ((tft_height - TFT_HEIGHT_HEADING) / (2 * menu_rows) +
            position * (tft_height - TFT_HEIGHT_HEADING) / (menu_rows) +
            letter_height);
  }
  return false;
}

void drawSelectedTemperature(float temperatureToDraw,
                             float previousTemperatureDrawn)
{
  setTextColor(COLOUR_MENU);
  drawFloat(previousTemperatureDrawn, 1, temperatureX, temperatureY,
            textFontSize);
  setTextColor(COLOUR_MENU_TEXT);
  drawFloat(temperatureToDraw, 1, temperatureX, temperatureY, textFontSize);
}

void drawUnselectedTemperature(float temperatureToDraw,
                               float previousTemperatureDrawn)
{
  tft.setTextColor(COLOUR_MENU);
  drawFloat(previousTemperatureDrawn, 1, tft_width / 2 - 20,
            tft_height / 2 + 10, textFontSize);
  tft.setTextColor(COLOUR_MENU_TEXT);
  drawFloat(temperatureToDraw, 1, tft_width / 2 - 20, tft_height / 2 + 10,
            textFontSize);
}

void drawHumidity(int UI_humidity, int UI_previousHumdity)
{
  setTextColor(COLOUR_MENU);
  drawCentreNumber(UI_previousHumdity, humidityX, humidityY);
  setTextColor(COLOUR_MENU_TEXT);
  drawCentreNumber(UI_humidity, humidityX, humidityY);
}

void drawHelpMessage(byte UI_language)
{
  switch (UI_language)
  {
  case ENGLISH:
    helpMessage = (char *)("Set desired parameters");
    break;
  case SPANISH:
    helpMessage = (char *)("Introduce parametros");
    break;
  case FRENCH:
    helpMessage = (char *)("Entrer parametres");
    break;
  case PORTUGUESE:
    helpMessage = (char *)("Insira os parametros");
    break;
  }
}

void drawStartMessage(bool UI_enableSet, int UI_menu_rows)
{
  uint16_t colour;
  if (blinkSetMessageState)
  {
    setTextColor(COLOUR_WARNING_TEXT);
    colour = COLOUR_WARNING_TEXT;
  }
  else
  {
    setTextColor(COLOUR_MENU);
    colour = COLOUR_MENU;
  }
  screenTextBackgroundColour = colour;
  tft.fillRect(width_select, (tft_height) - (tft_height - TFT_HEIGHT_HEADING - (UI_menu_rows - 1) * TFT_SEPARATOR_HEIGHT) / UI_menu_rows, tft_width - width_select, (tft_height - TFT_HEIGHT_HEADING - (UI_menu_rows - 1) * TFT_SEPARATOR_HEIGHT) / UI_menu_rows, colour);
  if (UI_enableSet)
  {
    setTextColor(COLOUR_MENU_TEXT);
    switch (in3.language)
    {
    case SPANISH:
      words[START_UI_ROW] = (char *)("EMPEZAR");
      break;
    case ENGLISH:
      words[START_UI_ROW] = (char *)("START");
      break;
    case FRENCH:
      words[START_UI_ROW] = (char *)("DEBUT");
      break;
    case PORTUGUESE:
      words[START_UI_ROW] = (char *)("COMECAR");
      break;
    }
    drawCentreString(words[START_UI_ROW],
                     width_select + (tft_width - width_select) / 2,
                     getYpos(UI_menu_rows, START_UI_ROW), textFontSize);
  }
  screenTextBackgroundColour = COLOUR_MENU;
}

void drawActuatorsSeparators()
{
  tft.fillRect(0, separatorTopYPos, tft_width, barThickness, COLOUR_FRAME_BAR);
  tft.fillRect(0, separatorMidYPos, tft_width, barThickness, COLOUR_FRAME_BAR);
}

void printLoadingTemperatureBar(double UI_desiredControlTemperature)
{
  drawFloat(UI_desiredControlTemperature, 1, tft_width - 5 * letter_width,
            temperatureY, textFontSize);
  for (int i = true; i <= barThickness; i++)
  {
    tft.drawRect(tempBarPosX - barWidth / 2 - i,
                 tempBarPosY - barHeight / 2 - i, barWidth + i * 2,
                 barHeight + i * 2, COLOUR_FRAME_BAR);
  }
}

void printLoadingHumidityBar(int UI_desiredControlHumidity)
{
  drawFloat(UI_desiredControlHumidity, 1, humBarPosX + barWidth / 2 + 10,
            humidityY, textFontSize);
  for (int i = true; i <= barThickness; i++)
  {
    tft.drawRect(humBarPosX - barWidth / 2 - i, humBarPosY - barHeight / 2 - i,
                 barWidth + i * 2, barHeight + i * 2, COLOUR_FRAME_BAR);
  }
}

void updateLoadingTemperatureBar(float prev, float actual)
{
  if (prev != actual)
  {
    float diff = (actual - prev) / 100;
    int colour;
    float barX;
    int barY, barDiffWidth;
    barX = tempBarPosX - (barWidth / 2) * (1 - prev / 50);
    barY = tempBarPosY - barHeight / 2;
    barDiffWidth = barWidth * abs(diff) + 1;
    if (diff > 0)
    {
      colour = COLOUR_LOADING_BAR;
    }
    else
    {
      colour = COLOUR_MENU;
      barX -= barDiffWidth - 1;
    }
    tft.fillRect(barX, barY, barDiffWidth, barHeight, colour);
  }
}

void updateLoadingHumidityBar(float prev, float actual)
{
  if (prev != actual)
  {
    float diff = (actual - prev) / 100;
    int colour;
    float barX;
    int barY, barDiffWidth;
    barX = humBarPosX - (barWidth / 2) * (1 - prev / 50);
    barY = humBarPosY - barHeight / 2;
    barDiffWidth = barWidth * abs(diff) + 1;
    if (diff > 0)
    {
      colour = COLOUR_LOADING_BAR;
    }
    else
    {
      colour = COLOUR_MENU;
      barX -= barDiffWidth - 1;
    }
    tft.fillRect(barX, barY, barDiffWidth, barHeight, colour);
  }
}

void blinkGoBackMessage()
{
  if (millis() - blinking > 1000)
  {
    blinking = millis();
    state_blink = !state_blink;
    if (state_blink)
    {
      setTextColor(ORANGE);
    }
    else
    {
      setTextColor(COLOUR_MENU);
      blinking += 400;
    }
    drawStop();
  }
}

int16_t drawCentreString(char *string, int16_t dX, int16_t poY, int16_t size)
{
  int16_t sumX = 0;
  int16_t len = 0;
  char *pointer = string;
  int16_t width = 8;
  int16_t gap = -2;

  while (*pointer)
  {
    len += (width + gap);
    *pointer++;
  }
  len = len * size;
  int16_t poX = dX - len / 2;
  if (poX < 0)
    poX = 0;

  while (*string)
  {
    tft.drawChar(poX, poY, *string, screenTextColor, screenTextBackgroundColour,
                 size);
    *string++;
    poX += (width + gap) * size; /* Move cursor right       */
  }
  return sumX;
}

int16_t drawRightString(char *string, int16_t dX, int16_t poY, int16_t size)
{
  int16_t sumX = 0;
  int16_t len = 0;
  char *pointer = string;
  int16_t width = 8;
  int16_t gap = -2;

  while (*pointer)
  {
    len += (width + gap);
    *pointer++;
  }

  len = len * size;
  int16_t poX = dX - len;

  if (poX < 0)
    poX = 0;

  while (*string)
  {
    tft.drawChar(poX, poY, *string, screenTextColor, screenTextBackgroundColour,
                 size);
    *string++;
    poX += (width + gap) * size; /* Move cursor right       */
  }

  return sumX;
}

int16_t drawFloat(float floatNumber, int16_t decimal, int16_t poX, int16_t poY,
                  int16_t size)
{
  unsigned long temp = 0;
  float decy = 0.0;
  float rounding = 0.5;
  float eep = 0.000001;
  int16_t sumX = 0;
  char negativeSymbol[] = "-";
  char decimalSymbol[] = ".";
  int16_t width = 8;
  int16_t gap = -2;
  int r = 1;

  if (floatNumber - 0.0 < eep) // floatNumber < 0
  {
    drawString(negativeSymbol, poX, poY, size);
    floatNumber = -floatNumber;
    poX += (width + gap) * size;
    sumX += (width + gap) * size;
  }

  for (unsigned char i = 0; i < decimal; ++i)
  {
    rounding /= 10.0;
  }
  floatNumber += rounding;
  temp = (long)floatNumber;
  drawNumber(temp, poX, poY, size);
  while (temp > 9)
  {
    temp /= 10;
    r++;
  }
  temp = (long)floatNumber;
  poX += (width + gap) * size * r;
  sumX += (width + gap) * size;

  if (decimal > 0)
  {
    drawString(decimalSymbol, poX, poY, size);
    poX += (width + gap) * size; /* Move cursor right            */
    sumX += (width + gap) * size;
  }
  else
  {
    return sumX;
  }

  decy = floatNumber - temp;
  for (unsigned char i = 0; i < decimal; i++)
  {
    decy *= 10;  /* for the next decimal         */
    temp = decy; /* get the decimal              */
    drawNumber(temp, poX, poY, size);

    poX += (width + gap) * size; /* Move cursor right            */
    sumX += (width + gap) * size;
    decy -= temp;
  }
  return sumX;
}

char *convertStringToChar(String input)
{
  char *cstr = new char[input.length() + 1];
  strcpy(cstr, input.c_str());
  return cstr;
}

char *convertStringToChar(char *arrayInput, String input)
{
  strcpy(arrayInput, input.c_str());
  return arrayInput;
}

void drawTemperatureUnits()
{
  drawRightString((char *)("/"), separatorPosition, ypos,
                  textFontSize);
  drawRightString((char *)("C"), unitPosition, ypos,
                  textFontSize);
}

void loadlogo()
{
  tft.setTextSize(1);
  if (UKRAINE_MODE)
  {
    tft.fillScreen(BLUE);
    tft.fillRect(0, tft_height / 2, tft_width, tft_height / 2, YELLOW);
    setTextColor(WHITE);
  }
  else if (SENEGAL_MODE)
  {
    tft.fillRect(0, 0, tft_width / 3, tft_height, GREEN);
    tft.fillRect(tft_width / 3, 0, tft_width / 3, tft_height, YELLOW);
    tft.fillRect(2 * tft_width / 3, 0, tft_width / 3, tft_height, RED);
    setTextColor(WHITE);
  }
  else
  {
    tft.fillScreen(introBackColor);
    tft.fillScreen(introBackColor);
    setTextColor(introTextColor);
  }
  drawIntroMessage();
}

/*
   Function pending to complete
*/
void drawHardwareErrorMessage(long error, bool criticalError,
                              bool calibrationError)
{
  tft.fillScreen(introBackColor);
  tft.setTextColor(
      introTextColor); // use tft. because tft.print is configured by it
  tft.setCursor(tft_width / 4 - hexDigits(error) * 16, tft_height / 10);
  tft.setTextSize(3);
  if (error || criticalError || calibrationError)
  {
    tft.print("HW error:");
    tft.println(error, HEX);
    tft.println();
    if (criticalError || calibrationError)
    {
      tft.setTextSize(3);
      if (criticalError)
      {
        tft.println("WIRING ERROR");
      }
      if (calibrationError)
      {
        tft.println("CALIBRATION ERROR");
      }
      tft.println();
    }
    switch (in3.language)
    {
    case SPANISH:
      textToWrite = (char *)(" Por favor contacta");
      break;
    case PORTUGUESE:
      textToWrite =
          (char *)(" Por favor entre em contato");
      break;
    case ENGLISH:
      textToWrite = (char *)(" Please contact");
      break;
    case FRENCH:
      textToWrite =
          (char *)(" S'il vous plait contactez");
      break;
    }
    tft.println(textToWrite);
    tft.setTextSize(2);
    tft.println("  medicalopenworld.org");
  }
  else
  {
    tft.print("SUCCESS :)");
  }
  tft.println();
  tft.println();
  tft.setTextSize(2);
  tft.print(" ");
  switch (in3.language)
  {
  case SPANISH:
    textToWrite = (char *)("Presione para continuar");
    break;
  case PORTUGUESE:
    textToWrite = (char *)("Pressione para continuar");
    break;
  case ENGLISH:
    textToWrite = (char *)("Press to continue");
    break;
  case FRENCH:
    textToWrite = (char *)("Appuyez pour continuer");
    break;
  }
  tft.println(textToWrite);
}

void graphics(uint8_t UI_page, uint8_t UI_language, uint8_t UI_print_text,
              uint8_t UI_menu_rows, uint8_t UI_var_0, uint8_t UI_var_1)
{
  setTextColor(COLOUR_MENU_TEXT);
  if (!UI_page)
  {
    tft.fillRect(width_select, TFT_HEIGHT_HEADING, tft_width - width_select,
                 tft_height - TFT_HEIGHT_HEADING, COLOUR_MENU);
  }
  else
  {
    tft.fillRect(0, TFT_HEIGHT_HEADING, tft_width, tft_height - TFT_HEIGHT_HEADING,
                 COLOUR_MENU);
  }
  if (UI_print_text)
  {
    if (UI_menu_rows)
    {
      tft.fillRect(0, TFT_HEIGHT_HEADING, width_select,
                   (tft_height - TFT_HEIGHT_HEADING) / UI_menu_rows,
                   COLOUR_SELECTED);
    }
  }
  for (int i = 2; i <= UI_menu_rows; i++)
  {
    if (UI_menu_rows)
    {
      tft.fillRect(0,
                   (tft_height - TFT_HEIGHT_HEADING) * (i - 1) / UI_menu_rows +
                       TFT_HEIGHT_HEADING,
                   width_select, (tft_height - TFT_HEIGHT_HEADING) / UI_menu_rows,
                   COLOUR_BAR);
      tft.fillRect(0,
                   (tft_height - TFT_HEIGHT_HEADING) * (i - 1) / UI_menu_rows +
                       TFT_HEIGHT_HEADING - 1,
                   tft_width, TFT_SEPARATOR_HEIGHT, WHITE);
    }
  }
  tft.drawRect(0, tft_height - 1, width_select, tft_height - 1, COLOUR_MENU);
  if (UI_print_text)
  {
    tft.setTextSize(1);
    for (int i = false; i < UI_menu_rows; i++)
    {
      ypos = graphicHeight(i);
      if (!pos_text[i])
      {
        drawString(words[i], width_select + side_gap, ypos, textFontSize);
      }
      else if (pos_text[i])
      {
        drawCentreString(words[i],
                         width_select + (tft_width - width_select) / 2, ypos,
                         textFontSize);
      }
      switch (UI_page)
      {
      case MAIN_MENU_PAGE:
        switch (i)
        {
        case CONTROL_MODE_UI_ROW:
          if (UI_var_0)
          {
            switch (in3.language)
            {
            case SPANISH:
              textToWrite = (char *)("AIRE");
              break;
            case ENGLISH:
              textToWrite = (char *)("AIR");
              break;
            case FRENCH:
              textToWrite = (char *)("AIR");
              break;
            case PORTUGUESE:
              textToWrite = (char *)("AR");
              break;
            }
            drawRightString(textToWrite, unitPosition, ypos, textFontSize);
          }
          else
          {
            switch (in3.language)
            {
            case SPANISH:
              textToWrite = (char *)("PIEL");
              break;
            case ENGLISH:
              textToWrite = (char *)("SKIN");
              break;
            case FRENCH:
              textToWrite = (char *)("PEAU");
              break;
            case PORTUGUESE:
              textToWrite = (char *)("PELE");
              break;
            }
            drawRightString(textToWrite, unitPosition, ypos, textFontSize);
          }
          break;
        case TEMPERATURE_UI_ROW:
          drawTemperatureUnits();
          drawRightString((char *)(initialSensorsValue),
                          initialSensorPosition, temperatureY,
                          textFontSize);
          break;
        case LED_UI_ROW:
          if (UI_var_1)
          {
            drawRightString((char *)("ON"),
                            unitPosition, ypos, textFontSize);
          }
          else
          {
            drawRightString((char *)("OFF"),
                            unitPosition, ypos, textFontSize);
          }
          break;
        case HUMIDITY_UI_ROW:
          drawHumidityUnits();
          drawRightString((char *)(initialSensorsValue),
                          initialSensorPosition, humidityY, textFontSize);
          break;
        }
        break;
      case SETTINGS_PAGE:
        switch (i)
        {
        case LANGUAGE_UI_ROW:
          switch (in3.language)
          {
          case SPANISH:
            textToWrite = (char *)("SPA");
            break;
          case ENGLISH:
            textToWrite = (char *)("ENG");
            break;
          case FRENCH:
            textToWrite = (char *)("FRA");
            break;
          case PORTUGUESE:
            textToWrite = (char *)("POR");
            break;
          }
          drawRightString(textToWrite, unitPosition, ypos, textFontSize);
          break;
        case SERIAL_NUMBER_UI_ROW:
          drawRightNumber(UI_var_0, unitPosition, ypos);
          break;
        case CCID_UI_ROW:
          drawCentreString(convertStringToChar(GPRS.CCID), tft_width / 2, ypos, textFontSize);
          break;
        case WIFI_EN_UI_ROW:
          if (UI_var_1)
          {
            drawRightString((char *)("ON"),
                            unitPosition, ypos, textFontSize);
            if (WiFi.status() == WL_CONNECTED)
            {
              drawCentreString(
                  convertStringToChar(cstring,
                                      String(WiFi.localIP()[0]) + "." +
                                          String(WiFi.localIP()[1]) + "." +
                                          String(WiFi.localIP()[2]) + "." +
                                          String(WiFi.localIP()[3])),
                  tft_width / 2, ypos, textFontSize);
            }
          }
          else
          {
            drawRightString((char *)("OFF"),
                            unitPosition, ypos, textFontSize);
          }
        }
        break;
      }
    }
  }
}
