pandemiaplan/IncuNest/(commit log)

2023-05-04 added ambient sensor, pending thingsboard publish
2023-05-05 added filtering, implemented fan speed, code refactoring
2023-05-05 added secundary current sensor
2023-05-06 fixed security feature disabling heater output
2023-05-14 added PID anti-windup
2023-09-27 Updated Max heater current
2023-10-06 Logging enhancement, power supply alarms
2023-10-06 enhanced buzzer and alarms
    [main.cpp, main.h, security.cpp, updateData.cpp, userInterface.cpp]
2024-01-01 Add calibration to telemetries
2024-01-03 Added calib values to TB, fix calib, refactor
    [UI_actuatorsProgress.cpp, UI_calibration.cpp, UI_mainMenu.cpp, UI_settings.cpp, calibrateSensors.cpp, drawGraphicInterphace.cpp, main.cpp, main.h]
2024-01-05 Fixed progress bar issue, code refactor
    [ISR.cpp, UI_actuatorsProgress.cpp, UI_calibration.cpp, UI_mainMenu.cpp, UI_settings.cpp, calibrateSensors.cpp, drawGraphicInterphace.cpp, main.cpp]
2024-01-15 Compatibility hw version 6.B
    [in3ator_OTA_partition_16MB.csv, in3ator_OTA_partition_4MB.csv]
2024-02-10 Added heater power control
2024-04-03 improved security debug
    [in3ator_OTA_partition_4MB.csv]
2024-05-15 Fixed dynamic JSON for telemetries
    [main.h]
2024-06-19 Calibration time shorted, minor fixes
    [EEPROM.cpp, ISR.cpp, board.h, calibrateSensors.cpp, drawGraphicInterphace.cpp, main.cpp, main.h, userInterface.cpp]
2024-07-17 i2c enhancements
2024-10-03 Version 15 base code
    [ESP32S3_OTA_partition_8MB.csv, ESP32_OTA_partition_16MB.csv, ESP32_OTA_partition_4MB.csv, in3ator_OTA_partition_16MB.csv]
2024-10-17 Fixed i2c issues
2024-12-05 Fixed thermal cutout issue
    [ISR.cpp, board.h, main.cpp, main.h, security.cpp]
2025-04-16 added latest phototherapy with current limiting
2025-04-22 Fixed reset behaviour, fixed fans + phototherapy
    [EEPROM.cpp, UI_actuatorsProgress.cpp, main.cpp, main.h, userInterface.cpp]
2025-06-04 added skin capacitance, minor fixes
    [EEPROM.cpp, board.h, calibrateSensors.cpp, main.cpp, main.h]
2025-09-17 v12, minor fixes
    [ESP32S3_OTA_partition_8MB.csv, ESP32_OTA_partition_16MB.csv, ESP32_OTA_partition_4MB.csv]
2025-10-02 Added sts35 support (pending further development)
    [huge_app.csv]
2025-10-14 Chore: line-endings policy and .gitignore
    [ESP32S3_OTA_partition_8MB.csv, ESP32_OTA_partition_16MB.csv, ESP32_OTA_partition_4MB.csv, huge_app.csv, in3ator_OTA_partition_16MB.csv]
2025-10-14 chore: ignore reserved-name file NUL
    [ESP32S3_OTA_partition_8MB.csv, ESP32_OTA_partition_16MB.csv, ESP32_OTA_partition_4MB.csv, huge_app.csv, in3ator_OTA_partition.csv, in3ator_OTA_partition_16MB.csv]
2025-10-14 Sync firmware + old tests; cleanup
    [AFE.SchDoc, Actuators.SchDoc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]
2025-10-14 renamed files
    [IncuNest.PrjPcb, IncuNest.step]
2025-10-14 chore: stop tracking all Hardware/**/History folders
    [Arcaboard.GBL, Arcaboard.GBO, Arcaboard.GBP, Arcaboard.GBS, Arcaboard.GKO, Arcaboard.GM1, Arcaboard.GTL, Arcaboard.GTO]
2025-10-14 chore: track heavy assets with Git LFS
2025-10-16 chaged directories
    [AFE.SchDoc, Actuators.SchDoc, Battery.SchDoc, Bill of Materials-PCB_Project.xlsx, Bill of Materials-in3ator(Main).xlsx, Bill of Materials-in3ator(Main)2.xlsx, Bill of Materials-in3ator(NO_AFE).xlsx, Bill of Materials-in3ator.xlsx]
2025-11-12 docs: documentar arquitectura integral de incunest
2025-11-12 docs: agregar guia para simulacion en wokwi
2025-11-12 Añade presentación IASA BTS de IncuNest
2026-01-16 Tighten HMI artifact path
